trevorfar/plant-sensor/hardware/digital.kicad_sch

## KiCad design hardware/digital.kicad_sch (2026-11-06)

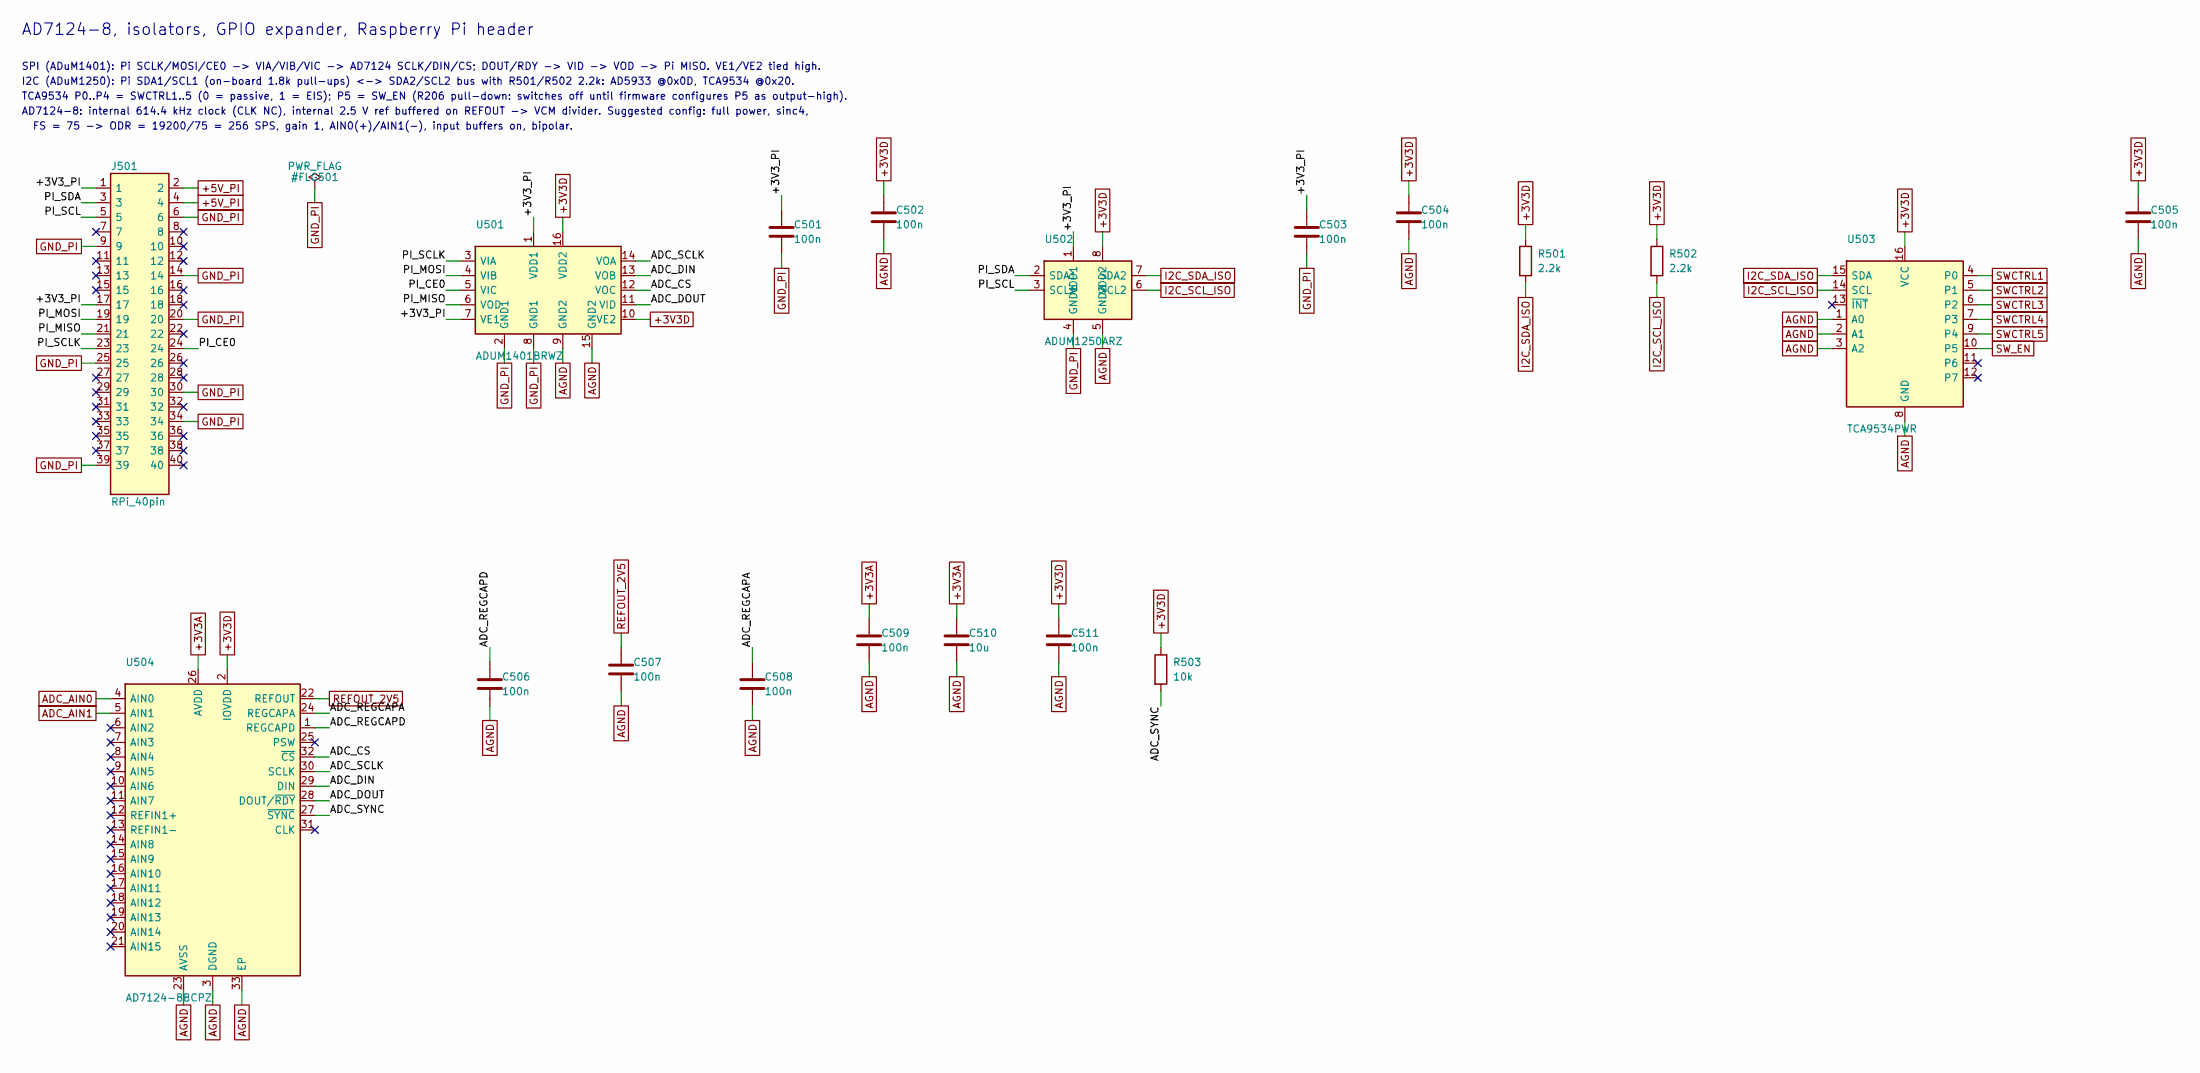
[picture p12: schematic digital.kicad_sch]

Parts:
C501, C502, C503, C504, C505, C506, C507, C508, C509, C511: 100n; C_0603_1608Metric; Tolerance 10%
C510: 10u; C_0805_2012Metric; Tolerance 20%
J501: RPi_40pin; PinSocket_2x20_P2.54mm_Vertical; MPN 2x20 2.54 mm socket
R501, R502: 2.2k; R_0603_1608Metric; Tolerance 1%
R503: 10k; R_0603_1608Metric; Tolerance 1%
U501: ADUM1401BRWZ; SOIC-16W_7.5x10.3mm_P1.27mm; MPN ADUM1401BRWZ
U502: ADUM1250ARZ; SOIC-8_3.9x4.9mm_P1.27mm; MPN ADUM1250ARZ
U503: TCA9534PWR; TSSOP-16_4.4x5mm_P0.65mm; MPN TCA9534PWR
U504: AD7124-8BCPZ; LFCSP-32-1EP_5x5mm_P0.5mm_EP3.5x3.5mm; MPN AD7124-8BCPZ

Connections:
+3V3A: C509.1, C510.1, U504.26 (AVDD)
+3V3D: C502.1, C504.1, C505.1, C511.1, R501.1, R502.1, R503.1, U501.10 (VE2), U501.16 (VDD2), U502.8 (VDD2), U503.16 (VCC), U504.2 (IOVDD)
+3V3_PI: C501.1, C503.1, J501.1, J501.17, U501.1 (VDD1), U501.7 (VE1), U502.1 (VDD1)
+5V_PI: J501.2, J501.4
ADC_AIN0: U504.4 (AIN0)
ADC_AIN1: U504.5 (AIN1)
ADC_CS: U501.12 (VOC), U504.32 (~CS)
ADC_DIN: U501.13 (VOB), U504.29 (DIN)
ADC_DOUT: U501.11 (VID), U504.28 (DOUT/~RDY)
ADC_REGCAPA: C508.1, U504.24 (REGCAPA)
ADC_REGCAPD: C506.1, U504.1 (REGCAPD)
ADC_SCLK: U501.14 (VOA), U504.30 (SCLK)
ADC_SYNC: R503.2, U504.27 (~SYNC)
AGND: C502.2, C504.2, C505.2, C506.2, C507.2, C508.2, C509.2, C510.2, C511.2, U501.9 (GND2), U501.15 (GND2), U502.5 (GND2), U503.1 (A0), U503.2 (A1), U503.3 (A2), U503.8 (GND), U504.3 (DGND), U504.23 (AVSS), U504.33 (EP)
GND_PI: C501.2, C503.2, J501.6, J501.9, J501.14, J501.20, J501.25, J501.30, J501.34, J501.39, U501.2 (GND1), U501.8 (GND1), U502.4 (GND1)
I2C_SCL_ISO: R502.2, U502.6 (SCL2), U503.14 (SCL)
I2C_SDA_ISO: R501.2, U502.7 (SDA2), U503.15 (SDA)
PI_CE0: J501.24, U501.5 (VIC)
PI_MISO: J501.21, U501.6 (VOD)
PI_MOSI: J501.19, U501.4 (VIB)
PI_SCL: J501.5, U502.3 (SCL1)
PI_SCLK: J501.23, U501.3 (VIA)
PI_SDA: J501.3, U502.2 (SDA1)
REFOUT_2V5: C507.1, U504.22 (REFOUT)
SWCTRL1: U503.4 (P0)
SWCTRL2: U503.5 (P1)
SWCTRL3: U503.6 (P2)
SWCTRL4: U503.7 (P3)
SWCTRL5: U503.9 (P4)
SW_EN: U503.10 (P5)

Notes on the sheet:
AD7124-8, isolators, GPIO expander, Raspberry Pi header
SPI (ADuM1401): Pi SCLK/MOSI/CE0 -> VIA/VIB/VIC -> AD7124 SCLK/DIN/CS; DOUT/RDY -> VID -> VOD -> Pi MISO. VE1/VE2 tied high.
I2C (ADuM1250): Pi SDA1/SCL1 (on-board 1.8k pull-ups) <-> SDA2/SCL2 bus with R501/R502 2.2k: AD5933 @0x0D, TCA9534 @0x20.
TCA9534 P0..P4 = SWCTRL1..5 (0 = passive, 1 = EIS); P5 = SW_EN (R206 pull-down: switches off until firmware configures P5 as output-high).
AD7124-8: internal 614.4 kHz clock (CLK NC), internal 2.5 V ref buffered on REFOUT -> VCM divider. Suggested config: full power, sinc4,
FS = 75 -> ODR = 19200/75 = 256 SPS, gain 1, AIN0(+)/AIN1(-), input buffers on, bipolar.
