trevorfar/plant-sensor/hardware/eis.kicad_sch

## KiCad design hardware/eis.kicad_sch (2026-11-06)

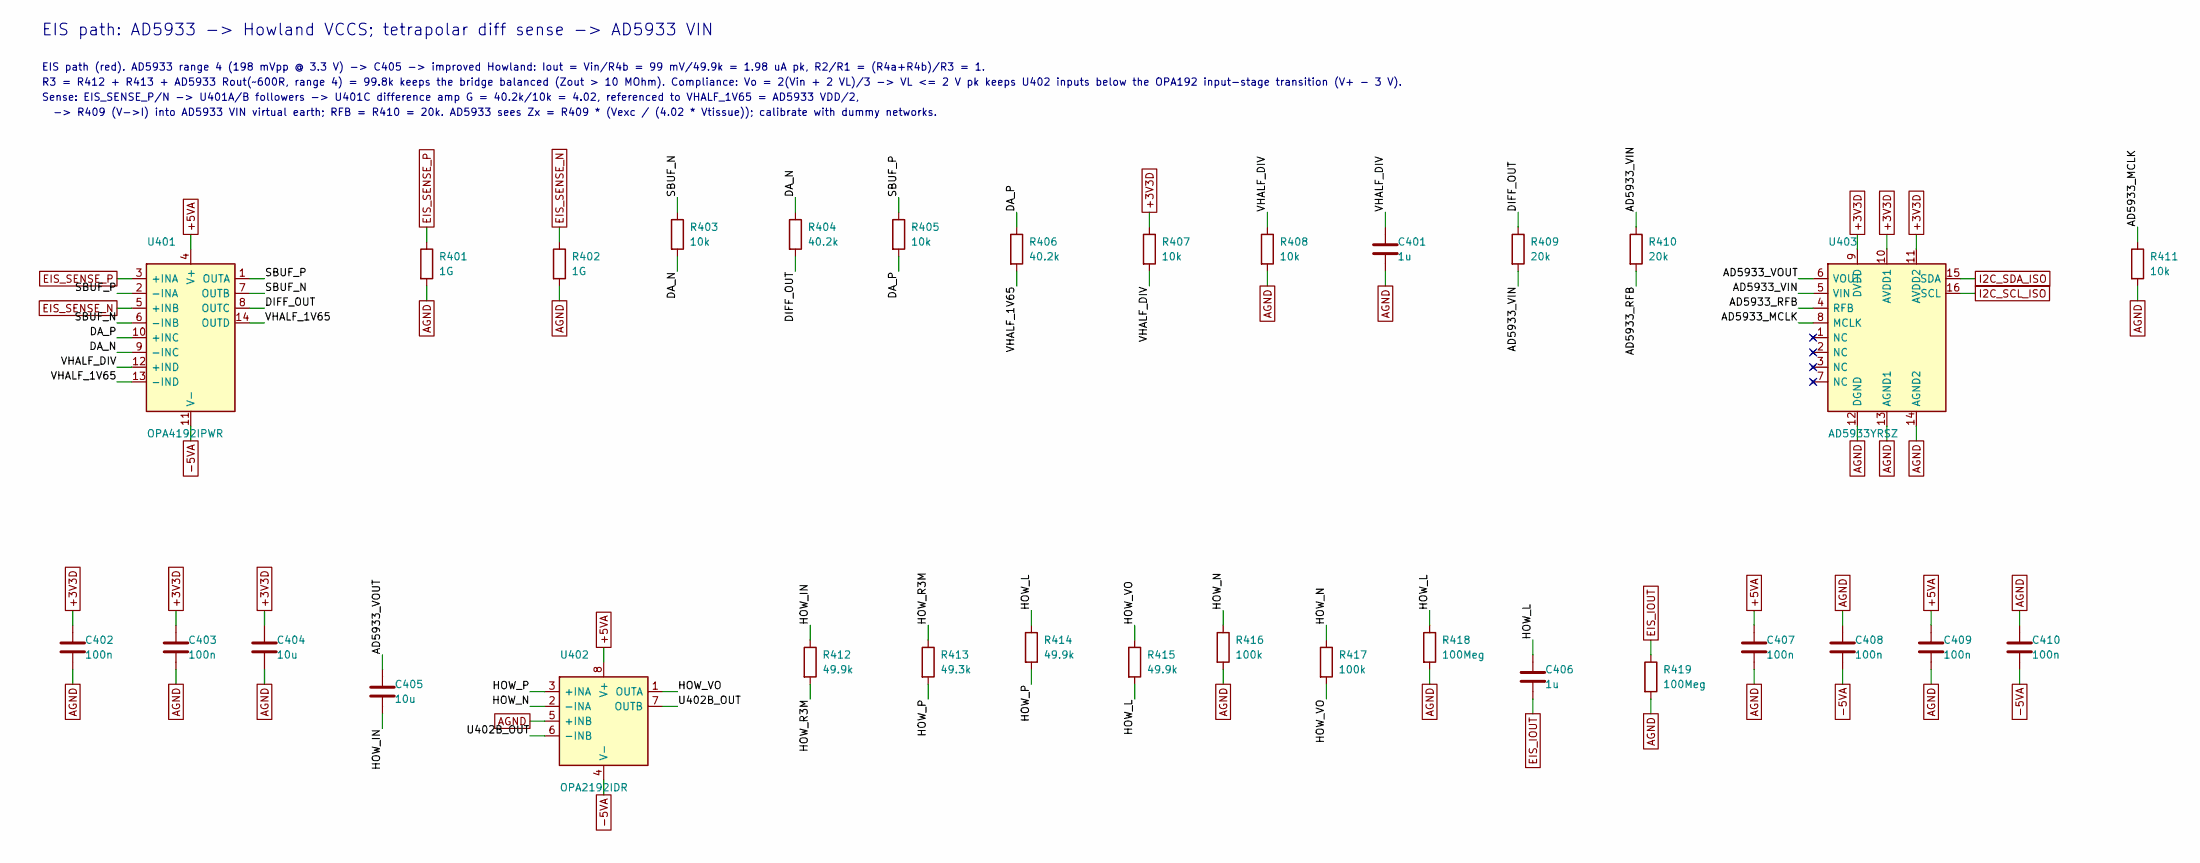
[picture p13: schematic eis.kicad_sch]

Parts:
C401, C406: 1u; C_0805_2012Metric; Tolerance 10%
C402, C403, C407, C408, C409, C410: 100n; C_0603_1608Metric; Tolerance 10%
C404: 10u; C_0805_2012Metric; Tolerance 20%
C405: 10u; C_0805_2012Metric; Tolerance 10%
R401, R402: 1G; R_1206_3216Metric; Tolerance 5%
R403, R405, R407, R408: 10k; R_0603_1608Metric; Tolerance 0.1%
R404, R406: 40.2k; R_0603_1608Metric; Tolerance 0.1%
R409, R410: 20k; R_0603_1608Metric; Tolerance 1%
R411: 10k; R_0603_1608Metric; Tolerance 1%
R412, R414, R415: 49.9k; R_0603_1608Metric; Tolerance 0.1%
R413: 49.3k; R_0603_1608Metric; Tolerance 0.1%
R416, R417: 100k; R_0603_1608Metric; Tolerance 0.1%
R418, R419: 100Meg; R_1206_3216Metric; Tolerance 5%
U401: OPA4192IPWR; TSSOP-14_4.4x5mm_P0.65mm; MPN OPA4192IPWR
U402: OPA2192IDR; SOIC-8_3.9x4.9mm_P1.27mm; MPN OPA2192IDR
U403: AD5933YRSZ; SSOP-16_5.3x6.2mm_P0.65mm; MPN AD5933YRSZ

Connections:
+3V3D: C402.1, C403.1, C404.1, R407.1, U403.9 (DVDD), U403.10 (AVDD1), U403.11 (AVDD2)
+5VA: C407.1, C409.1, U401.4 (V+), U402.8 (V+)
-5VA: C408.2, C410.2, U401.11 (V-), U402.4 (V-)
AD5933_MCLK: R411.1, U403.8 (MCLK)
AD5933_RFB: R410.2, U403.4 (RFB)
AD5933_VIN: R409.2, R410.1, U403.5 (VIN)
AD5933_VOUT: C405.1, U403.6 (VOUT)
AGND: C401.2, C402.2, C403.2, C404.2, C407.2, C408.1, C409.2, C410.1, R401.2, R402.2, R408.2, R411.2, R416.2, R418.2, R419.2, U402.5 (+INB), U403.12 (DGND), U403.13 (AGND1), U403.14 (AGND2)
DA_N: R403.2, R404.1, U401.9 (-INC)
DA_P: R405.2, R406.1, U401.10 (+INC)
DIFF_OUT: R404.2, R409.1, U401.8 (OUTC)
EIS_IOUT: C406.2, R419.1
EIS_SENSE_N: R402.1, U401.5 (+INB)
EIS_SENSE_P: R401.1, U401.3 (+INA)
HOW_IN: C405.2, R412.1
HOW_L: C406.1, R414.1, R415.2, R418.1
HOW_N: R416.1, R417.1, U402.2 (-INA)
HOW_P: R413.2, R414.2, U402.3 (+INA)
HOW_R3M: R412.2, R413.1
HOW_VO: R415.1, R417.2, U402.1 (OUTA)
I2C_SCL_ISO: U403.16 (SCL)
I2C_SDA_ISO: U403.15 (SDA)
SBUF_N: R403.1, U401.6 (-INB), U401.7 (OUTB)
SBUF_P: R405.1, U401.1 (OUTA), U401.2 (-INA)
U402B_OUT: U402.6 (-INB), U402.7 (OUTB)
VHALF_1V65: R406.2, U401.13 (-IND), U401.14 (OUTD)
VHALF_DIV: C401.1, R407.2, R408.1, U401.12 (+IND)

Notes on the sheet:
EIS path: AD5933 -> Howland VCCS; tetrapolar diff sense -> AD5933 VIN
EIS path (red). AD5933 range 4 (198 mVpp @ 3.3 V) -> C405 -> improved Howland: Iout = Vin/R4b = 99 mV/49.9k = 1.98 uA pk, R2/R1 = (R4a+R4b)/R3 = 1.
R3 = R412 + R413 + AD5933 Rout(~600R, range 4) = 99.8k keeps the bridge balanced (Zout > 10 MOhm). Compliance: Vo = 2(Vin + 2 VL)/3 -> VL <= 2 V pk keeps U402 inputs below the OPA192 input-stage transition (V+ - 3 V).
Sense: EIS_SENSE_P/N -> U401A/B followers -> U401C difference amp G = 40.2k/10k = 4.02, referenced to VHALF_1V65 = AD5933 VDD/2,
-> R409 (V->I) into AD5933 VIN virtual earth; RFB = R410 = 20k. AD5933 sees Zx = R409 * (Vexc / (4.02 * Vtissue)); calibrate with dummy networks.
