trevorfar/plant-sensor/hardware/electrodes.kicad_sch

## KiCad design hardware/electrodes.kicad_sch (2026-11-06)

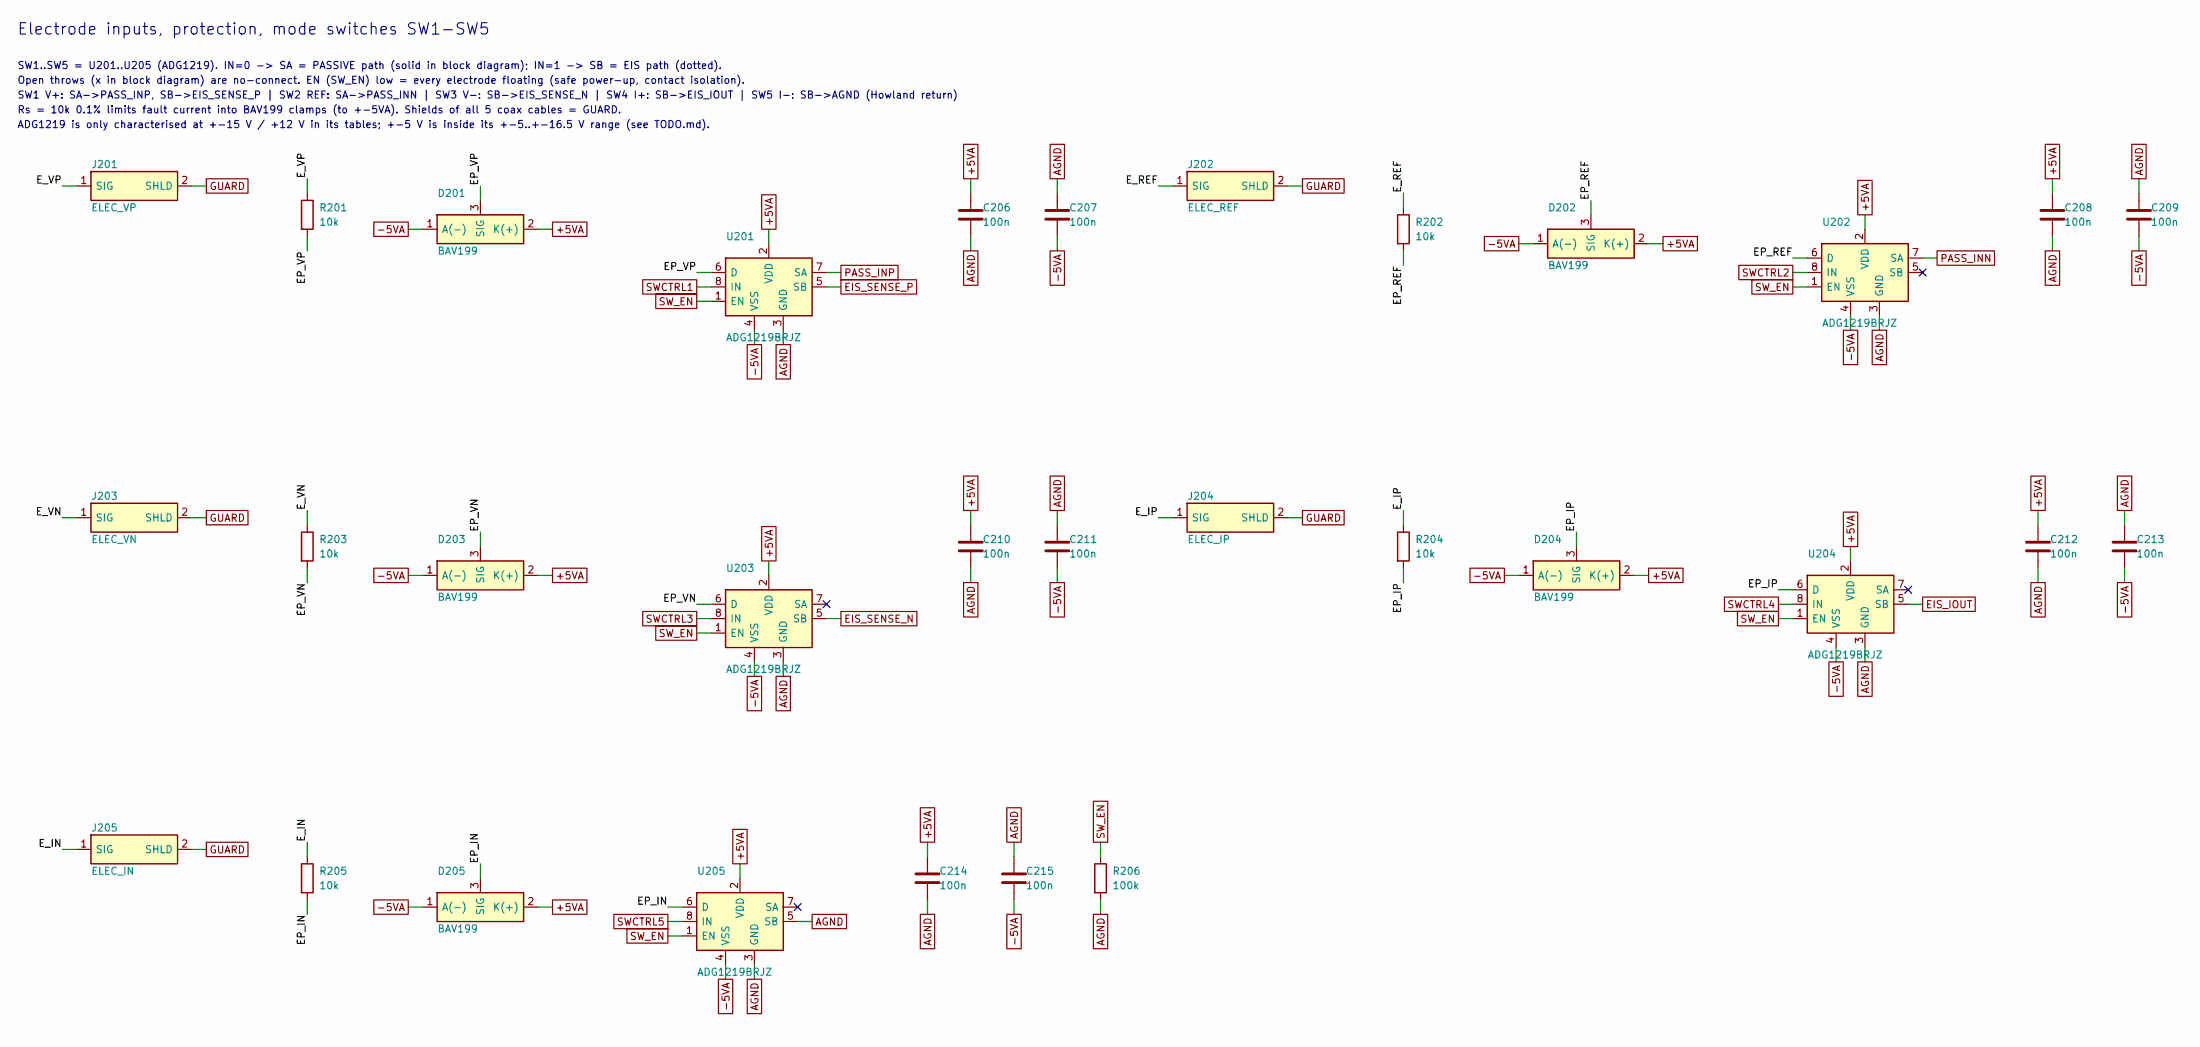
[picture p14: schematic electrodes.kicad_sch]

Parts:
C206, C207, C208, C209, C210, C211, C212, C213, C214, C215: 100n; C_0603_1608Metric; Tolerance 10%
D201, D202, D203, D204, D205: BAV199; SOT-23; MPN BAV199
J201: ELEC_VP; SMA_Amphenol_132134_Vertical; MPN SMA vertical jack
J202: ELEC_REF; SMA_Amphenol_132134_Vertical; MPN SMA vertical jack
J203: ELEC_VN; SMA_Amphenol_132134_Vertical; MPN SMA vertical jack
J204: ELEC_IP; SMA_Amphenol_132134_Vertical; MPN SMA vertical jack
J205: ELEC_IN; SMA_Amphenol_132134_Vertical; MPN SMA vertical jack
R201, R202, R203, R204, R205: 10k; R_0603_1608Metric; Tolerance 0.1%
R206: 100k; R_0603_1608Metric; Tolerance 1%
U201, U202, U203, U204, U205: ADG1219BRJZ; SOT-23-8; MPN ADG1219BRJZ

Connections:
+5VA: C206.1, C208.1, C210.1, C212.1, C214.1, D201.2 (K(+)), D202.2 (K(+)), D203.2 (K(+)), D204.2 (K(+)), D205.2 (K(+)), U201.2 (VDD), U202.2 (VDD), U203.2 (VDD), U204.2 (VDD), U205.2 (VDD)
-5VA: C207.2, C209.2, C211.2, C213.2, C215.2, D201.1 (A(-)), D202.1 (A(-)), D203.1 (A(-)), D204.1 (A(-)), D205.1 (A(-)), U201.4 (VSS), U202.4 (VSS), U203.4 (VSS), U204.4 (VSS), U205.4 (VSS)
AGND: C206.2, C207.1, C208.2, C209.1, C210.2, C211.1, C212.2, C213.1, C214.2, C215.1, R206.2, U201.3 (GND), U202.3 (GND), U203.3 (GND), U204.3 (GND), U205.3 (GND), U205.5 (SB)
EIS_IOUT: U204.5 (SB)
EIS_SENSE_N: U203.5 (SB)
EIS_SENSE_P: U201.5 (SB)
EP_IN: D205.3 (SIG), R205.2, U205.6 (D)
EP_IP: D204.3 (SIG), R204.2, U204.6 (D)
EP_REF: D202.3 (SIG), R202.2, U202.6 (D)
EP_VN: D203.3 (SIG), R203.2, U203.6 (D)
EP_VP: D201.3 (SIG), R201.2, U201.6 (D)
E_IN: J205.1 (SIG), R205.1
E_IP: J204.1 (SIG), R204.1
E_REF: J202.1 (SIG), R202.1
E_VN: J203.1 (SIG), R203.1
E_VP: J201.1 (SIG), R201.1
GUARD: J201.2 (SHLD), J202.2 (SHLD), J203.2 (SHLD), J204.2 (SHLD), J205.2 (SHLD)
PASS_INN: U202.7 (SA)
PASS_INP: U201.7 (SA)
SWCTRL1: U201.8 (IN)
SWCTRL2: U202.8 (IN)
SWCTRL3: U203.8 (IN)
SWCTRL4: U204.8 (IN)
SWCTRL5: U205.8 (IN)
SW_EN: R206.1, U201.1 (EN), U202.1 (EN), U203.1 (EN), U204.1 (EN), U205.1 (EN)

Notes on the sheet:
Electrode inputs, protection, mode switches SW1-SW5
SW1..SW5 = U201..U205 (ADG1219). IN=0 -> SA = PASSIVE path (solid in block diagram); IN=1 -> SB = EIS path (dotted).
Open throws (x in block diagram) are no-connect. EN (SW_EN) low = every electrode floating (safe power-up, contact isolation).
SW1 V+: SA->PASS_INP, SB->EIS_SENSE_P | SW2 REF: SA->PASS_INN | SW3 V-: SB->EIS_SENSE_N | SW4 I+: SB->EIS_IOUT | SW5 I-: SB->AGND (Howland return)
Rs = 10k 0.1% limits fault current into BAV199 clamps (to +-5VA). Shields of all 5 coax cables = GUARD.
ADG1219 is only characterised at +-15 V / +12 V in its tables; +-5 V is inside its +-5..+-16.5 V range (see TODO.md).
