trevorfar/plant-sensor/hardware/passive_afe.kicad_sch

## KiCad design hardware/passive_afe.kicad_sch (2026-11-06)

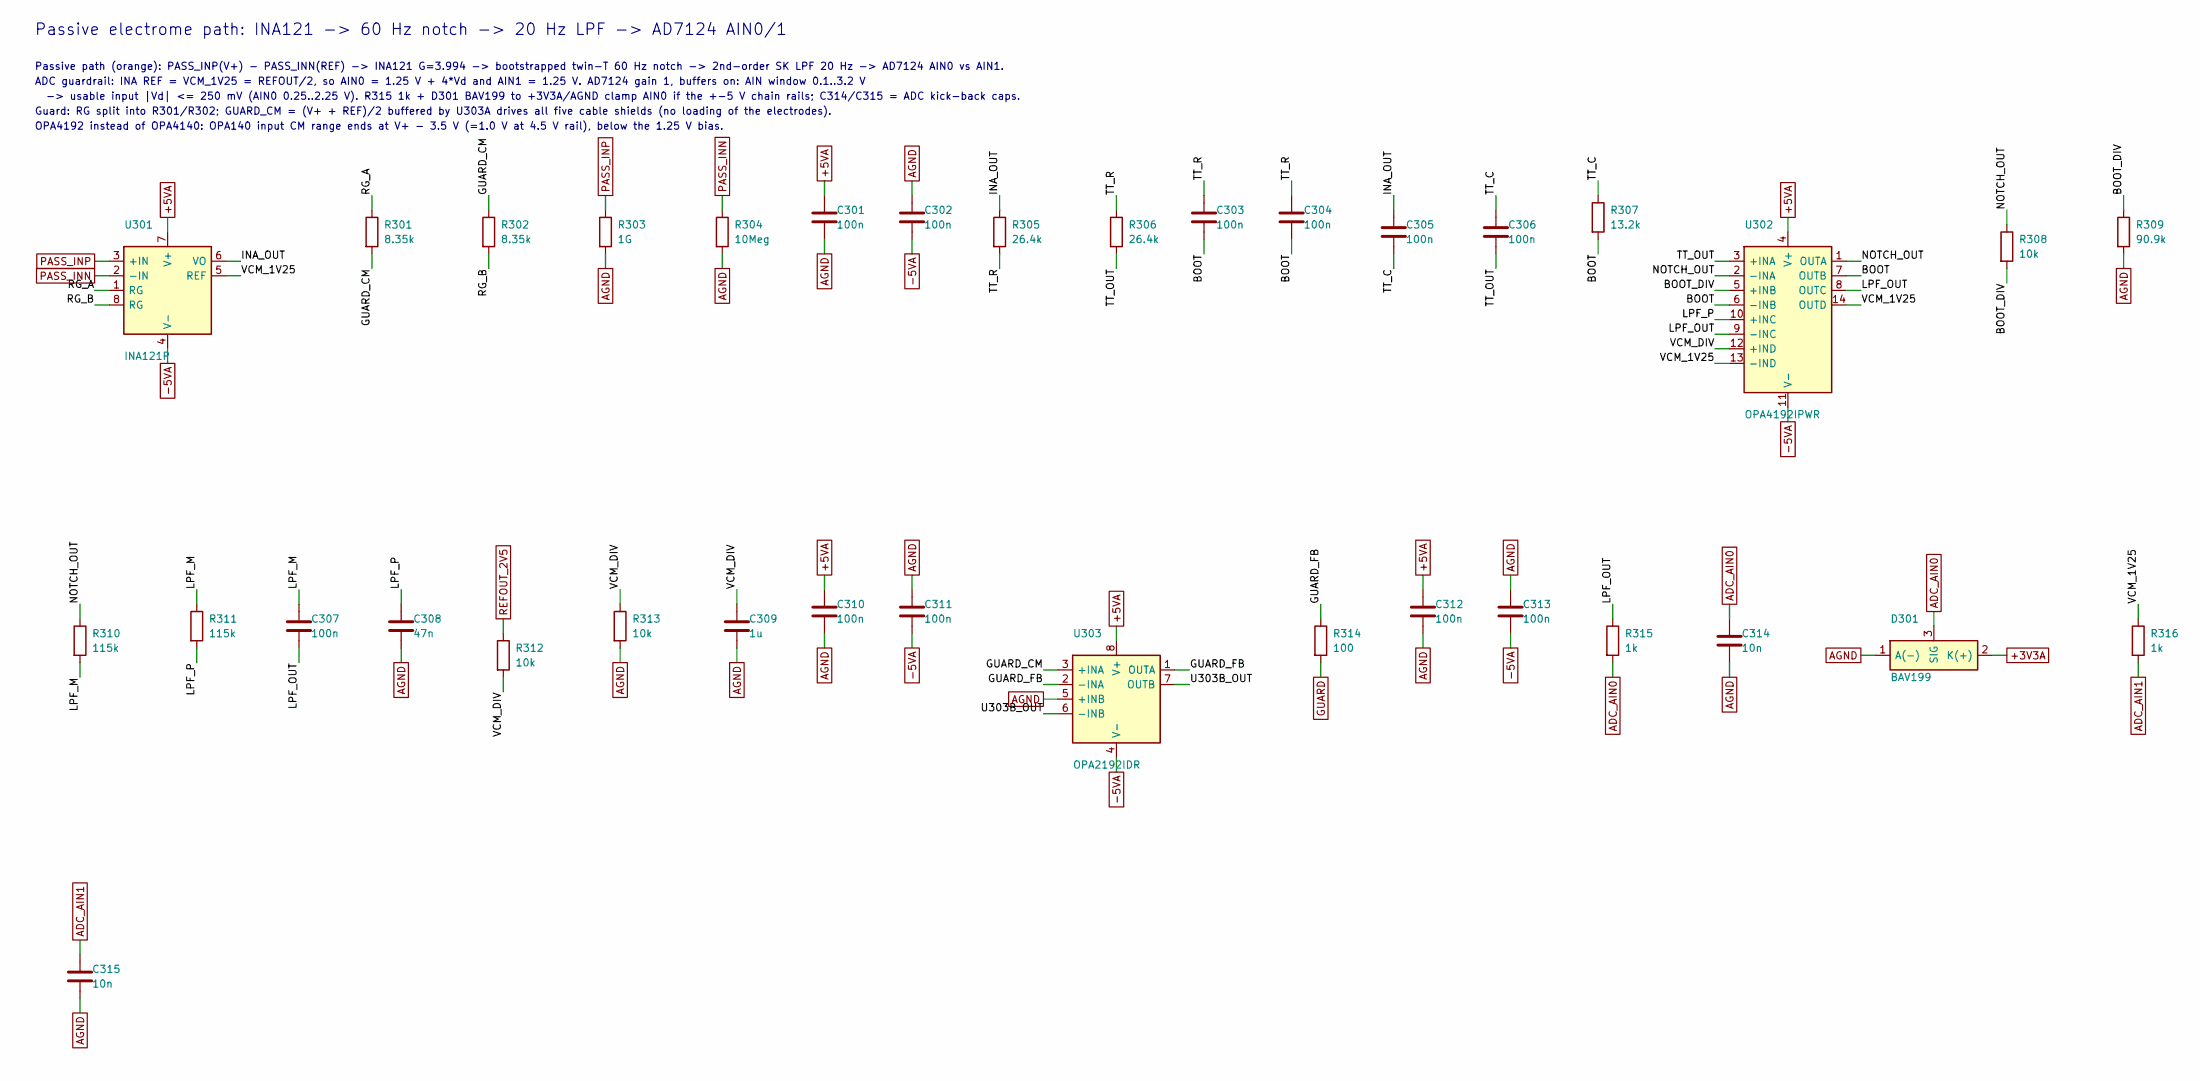
[picture p15: schematic passive_afe.kicad_sch]

Parts:
C301, C302, C310, C311, C312, C313: 100n; C_0603_1608Metric; Tolerance 10%
C303, C304, C305, C306, C307: 100n; C_1206_3216Metric; Tolerance 2%
C308: 47n; C_1206_3216Metric; Tolerance 2%
C309: 1u; C_0805_2012Metric; Tolerance 10%
C314, C315: 10n; C_0603_1608Metric; Tolerance 5%
D301: BAV199; SOT-23; MPN BAV199
R301, R302: 8.35k; R_0603_1608Metric; Tolerance 0.1%
R303: 1G; R_1206_3216Metric; Tolerance 5%
R304: 10Meg; R_1206_3216Metric; Tolerance 1%
R305, R306: 26.4k; R_0603_1608Metric; Tolerance 0.1%
R307: 13.2k; R_0603_1608Metric; Tolerance 0.1%
R308, R312, R313: 10k; R_0603_1608Metric; Tolerance 0.1%
R309: 90.9k; R_0603_1608Metric; Tolerance 0.1%
R310, R311: 115k; R_0603_1608Metric; Tolerance 1%
R314: 100; R_0603_1608Metric; Tolerance 1%
R315, R316: 1k; R_0603_1608Metric; Tolerance 1%
U301: INA121P; DIP-8_W7.62mm; MPN INA121P
U302: OPA4192IPWR; TSSOP-14_4.4x5mm_P0.65mm; MPN OPA4192IPWR
U303: OPA2192IDR; SOIC-8_3.9x4.9mm_P1.27mm; MPN OPA2192IDR

Connections:
+3V3A: D301.2 (K(+))
+5VA: C301.1, C310.1, C312.1, U301.7 (V+), U302.4 (V+), U303.8 (V+)
-5VA: C302.2, C311.2, C313.2, U301.4 (V-), U302.11 (V-), U303.4 (V-)
ADC_AIN0: C314.1, D301.3 (SIG), R315.2
ADC_AIN1: C315.1, R316.2
AGND: C301.2, C302.1, C308.2, C309.2, C310.2, C311.1, C312.2, C313.1, C314.2, C315.2, D301.1 (A(-)), R303.2, R304.2, R309.2, R313.2, U303.5 (+INB)
BOOT: C303.2, C304.2, R307.2, U302.6 (-INB), U302.7 (OUTB)
BOOT_DIV: R308.2, R309.1, U302.5 (+INB)
GUARD: R314.2
GUARD_CM: R301.2, R302.1, U303.3 (+INA)
GUARD_FB: R314.1, U303.1 (OUTA), U303.2 (-INA)
INA_OUT: C305.1, R305.1, U301.6 (VO)
LPF_M: C307.1, R310.2, R311.1
LPF_OUT: C307.2, R315.1, U302.8 (OUTC), U302.9 (-INC)
LPF_P: C308.1, R311.2, U302.10 (+INC)
NOTCH_OUT: R308.1, R310.1, U302.1 (OUTA), U302.2 (-INA)
PASS_INN: R304.1, U301.2 (-IN)
PASS_INP: R303.1, U301.3 (+IN)
REFOUT_2V5: R312.1
RG_A: R301.1, U301.1 (RG)
RG_B: R302.2, U301.8 (RG)
TT_C: C305.2, C306.1, R307.1
TT_OUT: C306.2, R306.2, U302.3 (+INA)
TT_R: C303.1, C304.1, R305.2, R306.1
U303B_OUT: U303.6 (-INB), U303.7 (OUTB)
VCM_1V25: R316.1, U301.5 (REF), U302.13 (-IND), U302.14 (OUTD)
VCM_DIV: C309.1, R312.2, R313.1, U302.12 (+IND)

Notes on the sheet:
Passive electrome path: INA121 -> 60 Hz notch -> 20 Hz LPF -> AD7124 AIN0/1
Passive path (orange): PASS_INP(V+) - PASS_INN(REF) -> INA121 G=3.994 -> bootstrapped twin-T 60 Hz notch -> 2nd-order SK LPF 20 Hz -> AD7124 AIN0 vs AIN1.
ADC guardrail: INA REF = VCM_1V25 = REFOUT/2, so AIN0 = 1.25 V + 4*Vd and AIN1 = 1.25 V. AD7124 gain 1, buffers on: AIN window 0.1..3.2 V
-> usable input |Vd| <= 250 mV (AIN0 0.25..2.25 V). R315 1k + D301 BAV199 to +3V3A/AGND clamp AIN0 if the +-5 V chain rails; C314/C315 = ADC kick-back caps.
Guard: RG split into R301/R302; GUARD_CM = (V+ + REF)/2 buffered by U303A drives all five cable shields (no loading of the electrodes).
OPA4192 instead of OPA4140: OPA140 input CM range ends at V+ - 3.5 V (=1.0 V at 4.5 V rail), below the 1.25 V bias.
