trevorfar/plant-sensor/hardware/power.kicad_sch

## KiCad design hardware/power.kicad_sch (2026-11-06)

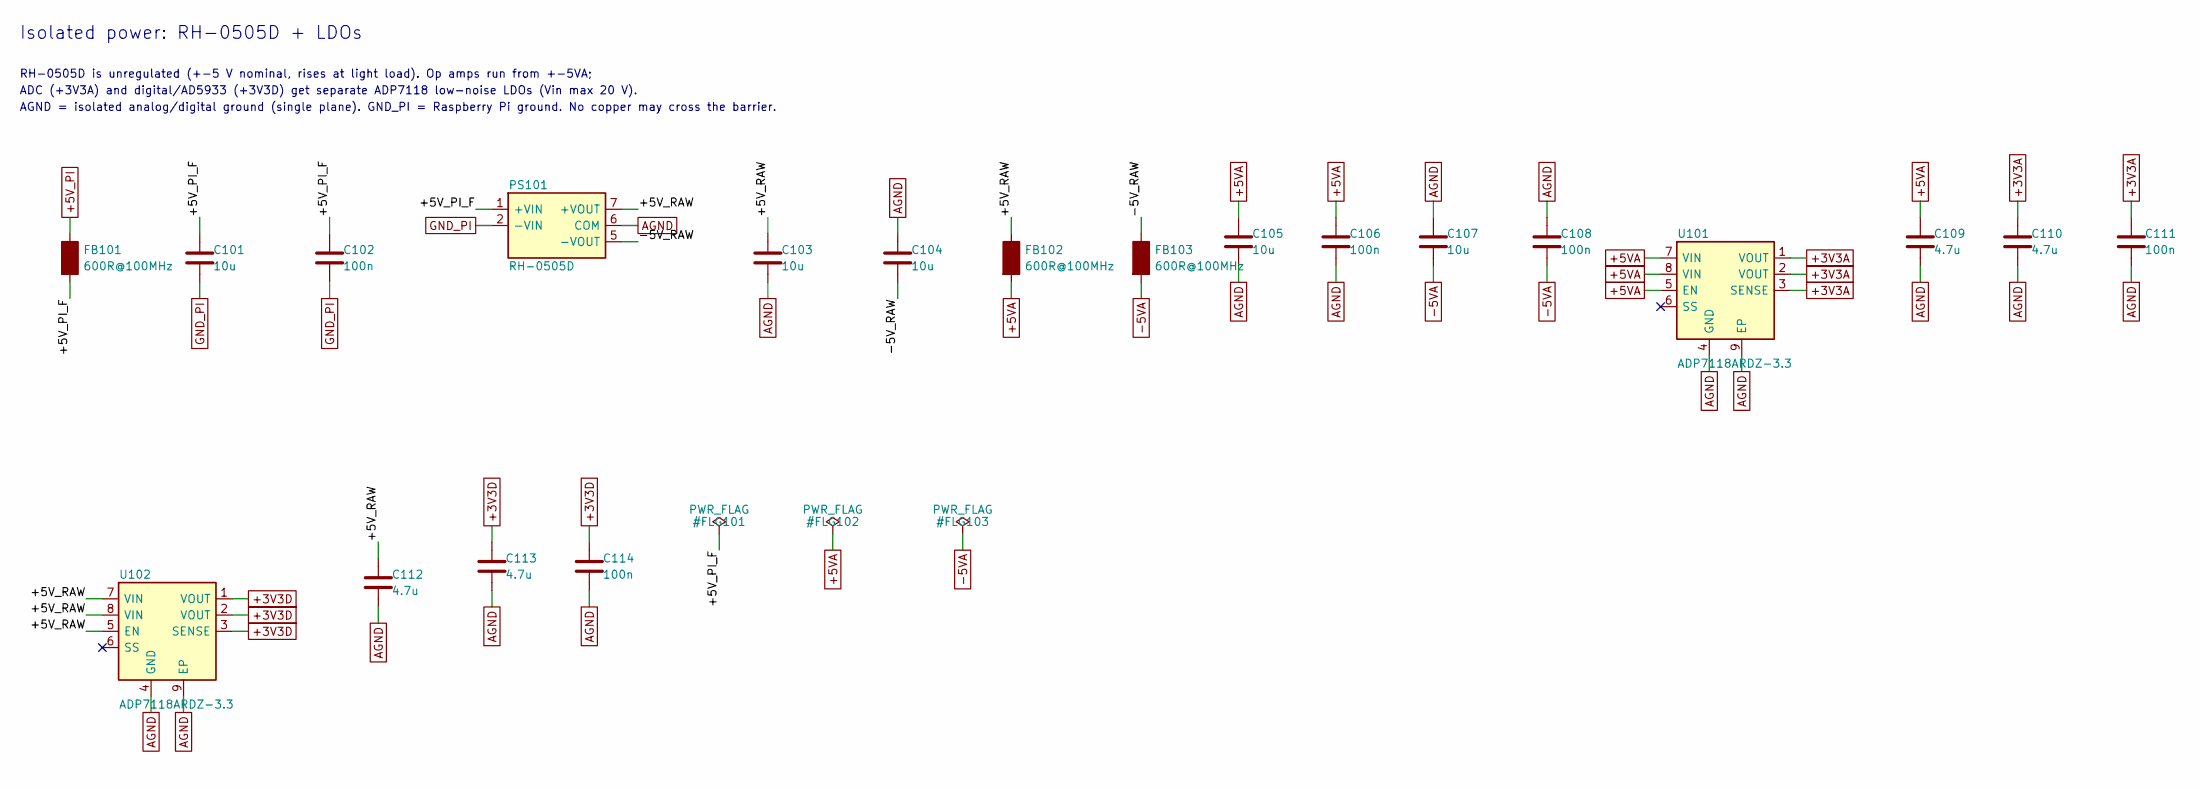
[picture p16: schematic power.kicad_sch]

Parts:
C101, C103, C104, C105, C107: 10u; C_0805_2012Metric; Tolerance 20%
C102, C106, C108, C111, C114: 100n; C_0603_1608Metric; Tolerance 10%
C109, C110, C112, C113: 4.7u; C_0805_2012Metric; Tolerance 10%
FB101, FB102, FB103: 600R@100MHz; L_0603_1608Metric
PS101: RH-0505D; PinHeader_1x07_P2.54mm_Vertical; MPN RH-0505D
U101, U102: ADP7118ARDZ-3.3; SOIC-8-1EP_3.9x4.9mm_P1.27mm_EP2.29x3mm; MPN ADP7118ARDZ-3.3

Connections:
+3V3A: C110.1, C111.1, U101.1 (VOUT), U101.2 (VOUT), U101.3 (SENSE)
+3V3D: C113.1, C114.1, U102.1 (VOUT), U102.2 (VOUT), U102.3 (SENSE)
+5VA: C105.1, C106.1, C109.1, FB102.2, U101.5 (EN), U101.7 (VIN), U101.8 (VIN)
+5V_PI: FB101.1
+5V_PI_F: C101.1, C102.1, FB101.2, PS101.1 (+VIN)
+5V_RAW: C103.1, C112.1, FB102.1, PS101.7 (+VOUT), U102.5 (EN), U102.7 (VIN), U102.8 (VIN)
-5VA: C107.2, C108.2, FB103.2
-5V_RAW: C104.2, FB103.1, PS101.5 (-VOUT)
AGND: C103.2, C104.1, C105.2, C106.2, C107.1, C108.1, C109.2, C110.2, C111.2, C112.2, C113.2, C114.2, PS101.6 (COM), U101.4 (GND), U101.9 (EP), U102.4 (GND), U102.9 (EP)
GND_PI: C101.2, C102.2, PS101.2 (-VIN)

Notes on the sheet:
Isolated power: RH-0505D + LDOs
RH-0505D is unregulated (+-5 V nominal, rises at light load). Op amps run from +-5VA;
ADC (+3V3A) and digital/AD5933 (+3V3D) get separate ADP7118 low-noise LDOs (Vin max 20 V).
AGND = isolated analog/digital ground (single plane). GND_PI = Raspberry Pi ground. No copper may cross the barrier.
